MakerThornhill/Syma_X5C_servo/images/header.jpg

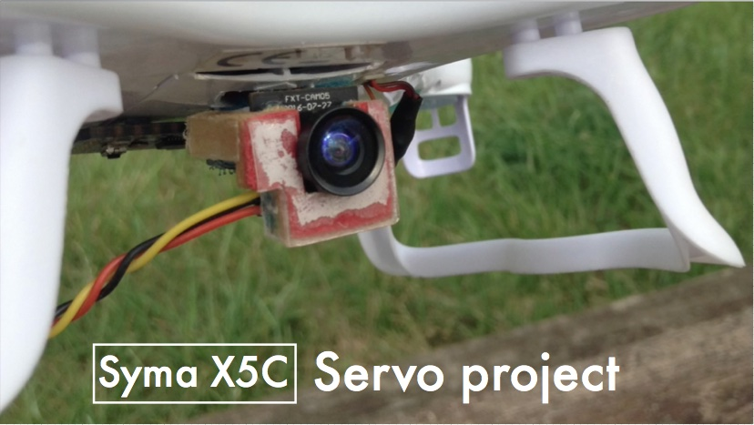
images/header.jpg
