MakerThornhill/Syma_X5C_servo/images/trinket.jpg

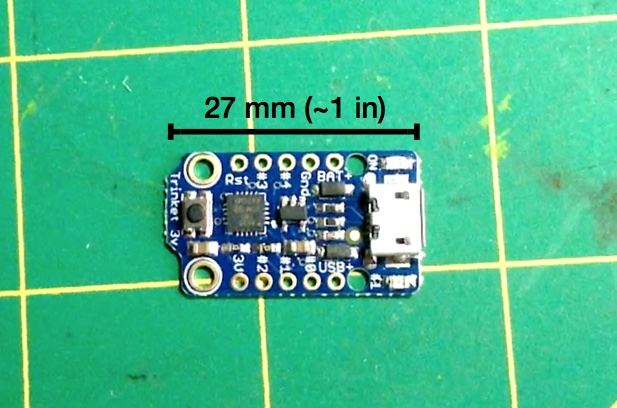
images/trinket.jpg
