MakerThornhill/Syma_X5C_servo/(commit log)

2017-04-16 Syma servo sketch
    Woo!
2017-04-24 Update Syma_servo_trinket.ino
    Adjusted the servo positions after switching to the Trinket & soft_servo library.
2017-04-28 Added rough schematic
2017-04-28 Added schematic to readme
2017-05-02 Added signal source to readme
    Found the RCgroups source I used for my voltage timings
2017-05-03 Edit to the schematic
    Label showing the X5C's camera port was hidden. Also reduced some whitespace
2017-05-03 Added schematic.jpg to image folder
2017-05-03 New image path for schematic.jpg
2017-05-03 deleted original schematic image
    ...because now it's in the image folder
2017-05-03 Updated ReadMe
    Added a download section... in case it's not obvious which is the Arduino sketch
2017-05-12 Link to the sketch to detect the camera signal
    Added a link to point people to just the signal detection sketch, so they can easily adapt the code for their own projects
2017-05-14 LED function & clean up
    + Created a function to blink the LED
    * Now using LED_BUILTIN
    * Cleaned everything up (thanks Auto Format)
2017-07-21 3 Position sketch
    Sketch to move servo between 0, -45, and -90 degrees
2017-08-13 Added return to horizontal view function
    Added a function to make the servo return to the default horizontal position when a button is pressed (useful for the 3-position sketch, where you might want to quickly look ahead but are in the middle of the toggle sequence). Also switched buttons so lower video button now toggles servo position, and the faster picture button returns to horizontal
